mechasB/PID_Controller_Project/simulation/Identyfikacja/identyfikacja_cftool.png

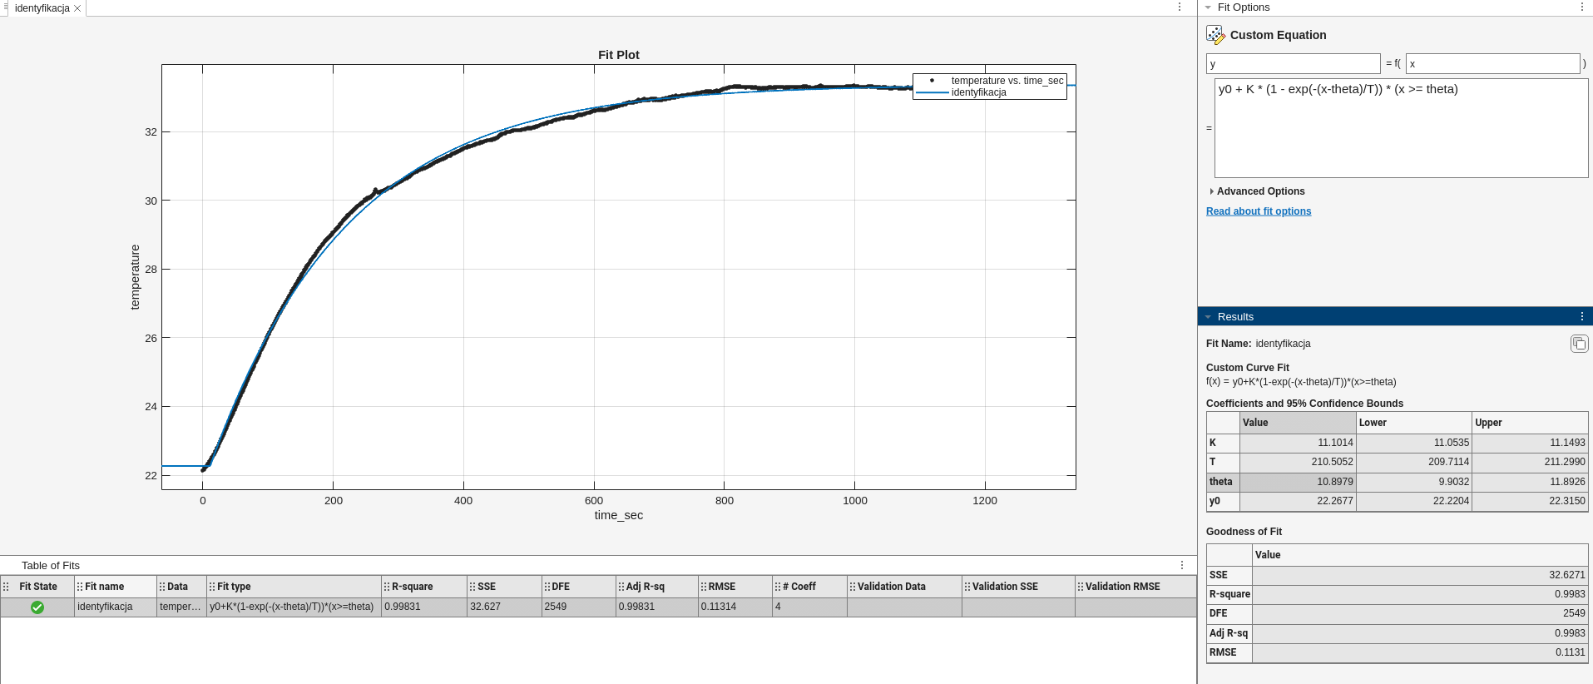
simulation/Identyfikacja/identyfikacja_cftool.png
