mechasB/PID_Controller_Project/hardware/PID_Controller_Project/PID_Controller_Project.kicad_sch

## KiCad design hardware/PID_Controller_Project/PID_Controller_Project.kicad_sch (2025-12-23, an earlier design)

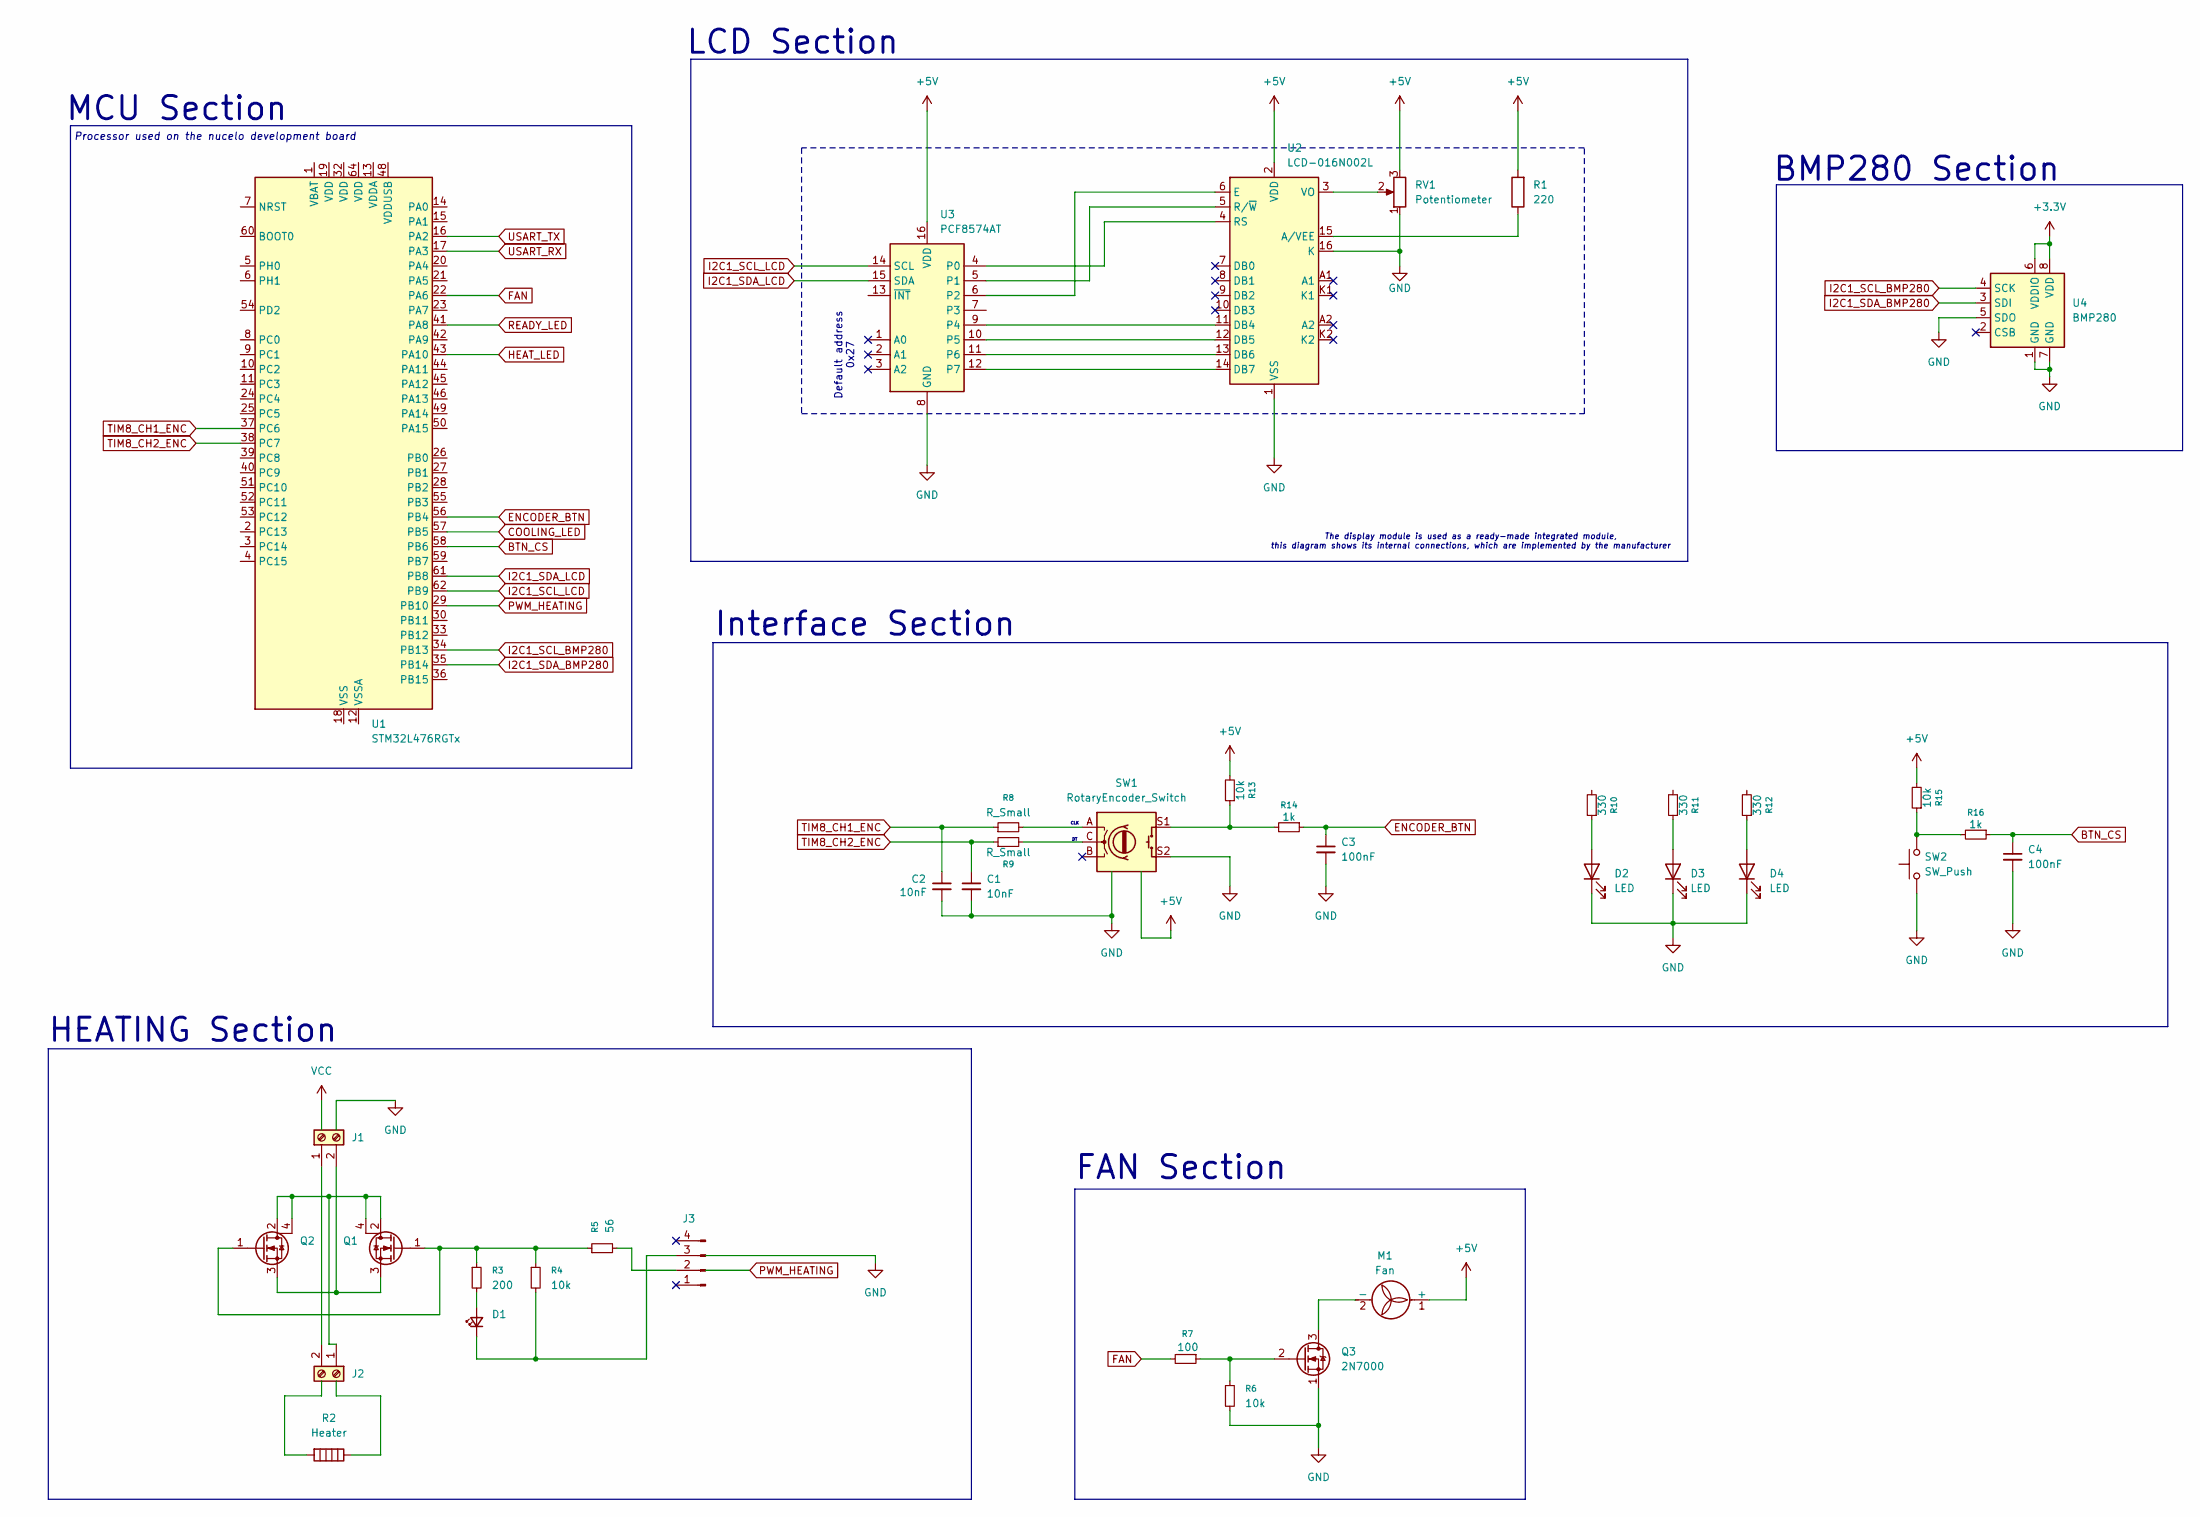
[picture p10: schematic PID_Controller_Project.kicad_sch]

Parts:
C1, C2: 10nF
C3, C4: 100nF
D1: LED_Small
D2, D3, D4: LED
J1, J2: Screw_Terminal_01x02
J3: Conn_01x04_Pin
M1: Fan
Q1, Q2: Q_NMOS_GDSD
Q3: 2N7000; TO-92_Inline
R1: 220
R2: Heater
R3: 200
R4, R6, R13, R15: 10k
R5: 56
R7: 100
R8, R9: R_Small
R10, R11, R12: 330
R14, R16: 1k
RV1: Potentiometer
SW1: RotaryEncoder_Switch
SW2: SW_Push
U1: STM32L476RGTx; LQFP-64_10x10mm_P0.5mm
U2: LCD-016N002L
U3: PCF8574AT; SOIC-16W_7.5x10.3mm_P1.27mm
U4: BMP280; Bosch_LGA-8_2x2.5mm_P0.65mm_ClockwisePinNumbering

Connections:
+3.3V: U4.6 (VDDIO), U4.8 (VDD)
+5V: M1.1 (+), R1.2, R13.2, R15.2, RV1.3, U2.2 (VDD), U3.16 (VDD)
BTN_CS: C4.1, R16.1, U1.58 (PB6)
COOLING_LED: U1.57 (PB5)
ENCODER_BTN: C3.1, R14.1, U1.56 (PB4)
FAN: R7.2, U1.22 (PA6)
GND: C1.2, C2.2, C3.2, C4.2, D2.1 (K), D3.1 (K), D4.1 (K), Q3.1 (S), R6.2, RV1.1, SW1.S2, SW2.1, U2.1 (VSS), U2.16 (K), U3.8 (GND), U4.1 (GND), U4.5 (SDO), U4.7 (GND)
HEAT_LED: U1.43 (PA10)
I2C1_SCL_BMP280: U1.34 (PB13), U4.4 (SCK)
I2C1_SCL_LCD: U1.62 (PB9), U3.14 (SCL)
I2C1_SDA_BMP280: U1.35 (PB14), U4.3 (SDI)
I2C1_SDA_LCD: U1.61 (PB8), U3.15 (SDA)
unnamed: D1.1 (K), J3.3, R4.2
unnamed: D1.2 (A), R3.2
unnamed: D2.2 (A), R10.1
unnamed: D3.2 (A), R11.1
unnamed: D4.2 (A), R12.1
unnamed: J1.1, J2.2
unnamed: J1.2, Q1.3 (S), Q2.3 (S)
unnamed: J2.1, Q1.2 (D), Q1.4 (D), Q2.2 (D), Q2.4 (D)
unnamed: J3.2, R5.2
unnamed: M1.2 (-), Q3.3 (D)
unnamed: Q1.1 (G), Q2.1 (G), R3.1, R4.1, R5.1
unnamed: Q3.2 (G), R6.1, R7.1
unnamed: R1.1, U2.15 (A/VEE)
unnamed: R8.2, SW1.A
unnamed: R9.2, SW1.C
unnamed: R13.1, R14.2, SW1.S1
unnamed: R15.1, R16.2, SW2.2
unnamed: RV1.2, U2.3 (VO)
unnamed: U1.18 (VSS), U1.31 (VSS), U1.47 (VSS), U1.63 (VSS)
unnamed: U2.4 (RS), U3.4 (P0)
unnamed: U2.5 (R/~W), U3.5 (P1)
unnamed: U2.6 (E), U3.6 (P2)
unnamed: U2.11 (DB4), U3.9 (P4)
unnamed: U2.12 (DB5), U3.10 (P5)
unnamed: U2.13 (DB6), U3.11 (P6)
unnamed: U2.14 (DB7), U3.12 (P7)
PWM_HEATING: U1.29 (PB10)
READY_LED: U1.41 (PA8)
TIM8_CH1_ENC: C2.1, R8.1, U1.37 (PC6)
TIM8_CH2_ENC: C1.1, R9.1, U1.38 (PC7)
USART_RX: U1.17 (PA3)
USART_TX: U1.16 (PA2)

Notes on the sheet:
Default address 0x27
BMP280 Section
Interface Section
Processor used on the nucelo development board
HEATING Section
LCD Section
MCU Section
FAN Section
CLK
The display module is used as a ready-made integrated module, this diagram shows its internal connections, which are implemented by the manufacturer
