mechasB/PID_Controller_Project/software/Firmware/Firmware.ioc

Mcu.UserName=STM32L476RGTx
PA10.GPIO_Label=HEAT_LED
PA10.Signal=GPIO_Output
PA2.GPIO_Label=USART_TX
PA2.Signal=USART2_TX
PA3.GPIO_Label=USART_RX
PA3.Signal=USART2_RX
PA5.GPIO_Label=LD2 [green Led]
PA5.Signal=GPIO_Output
PA6.GPIO_Label=FAN
PA6.Signal=GPIO_Output
PA7.Signal=GPIO_Output
PA8.GPIO_Label=READY_LED
PA8.Signal=GPIO_Output
PB10.Signal=S_TIM2_CH3
PB13.Signal=I2C2_SCL
PB14.Signal=I2C2_SDA
PB5.GPIO_Label=COOLING_LED
PB5.Signal=GPIO_Output
PB6.GPIO_Label=BTN_CS
PB6.Signal=GPIO_Input
PB8.Signal=I2C1_SCL
PB9.Signal=I2C1_SDA
PC13.GPIO_Label=B1 [Blue PushButton]
PC13.Signal=GPXTI13
PC6.Signal=S_TIM8_CH1
PC7.Signal=S_TIM8_CH2
