mechasB/PID_Controller_Project/software/Firmware/Core/Inc/main.h

#define B1_Pin GPIO_PIN_13
#define B1_GPIO_Port GPIOC
#define USART_TX_Pin GPIO_PIN_2
#define USART_TX_GPIO_Port GPIOA
#define USART_RX_Pin GPIO_PIN_3
#define USART_RX_GPIO_Port GPIOA
#define LD2_Pin GPIO_PIN_5
#define LD2_GPIO_Port GPIOA
#define FAN_Pin GPIO_PIN_6
#define FAN_GPIO_Port GPIOA
#define READY_LED_Pin GPIO_PIN_8
#define READY_LED_GPIO_Port GPIOA
#define HEAT_LED_Pin GPIO_PIN_10
#define HEAT_LED_GPIO_Port GPIOA
#define TMS_Pin GPIO_PIN_13
#define TMS_GPIO_Port GPIOA
#define TCK_Pin GPIO_PIN_14
#define TCK_GPIO_Port GPIOA
#define SWO_Pin GPIO_PIN_3
#define SWO_GPIO_Port GPIOB
#define ENCODER_BTN_Pin GPIO_PIN_4
#define ENCODER_BTN_GPIO_Port GPIOB
#define COOLING_LED_Pin GPIO_PIN_5
#define COOLING_LED_GPIO_Port GPIOB
#define BTN_CS_Pin GPIO_PIN_6
#define BTN_CS_GPIO_Port GPIOB
