mechasB/PID_Controller_Project/software/Firmware/Components/Encoder/encoder_config.h

#ifndef INC_ENCODER_CONFIG_H_
#define INC_ENCODER_CONFIG_H_

/* Config --------------------------------------------------------------------*/

/* Includes ------------------------------------------------------------------*/
#include "encoder.h"

/* Typedef -------------------------------------------------------------------*/

/* Define --------------------------------------------------------------------*/

/* Macro ---------------------------------------------------------------------*/

/* Public variables ----------------------------------------------------------*/
extern ENC_Handle_TypeDef henc1;

/* Public function prototypes ------------------------------------------------*/

#endif /* INC_ENCODER_CONFIG_H_ */
