mechasB/PID_Controller_Project/(commit log)

2025-10-24 Add ArduinoJson lib
2025-11-22 adc lcd lib, work on encoder
2025-11-22 Work on encoder counting
2025-11-23 Add encoder lib and refresh cmake
2025-11-23 encoder working
2025-11-23 add uart interface
2025-12-08 make schematic
    [PID_Controller_Project.kicad_pcb, PID_Controller_Project.kicad_sch]
2025-12-08 add display on lcd temperatures
2025-12-08 set temperatur by enocoder and display values on lcd
2025-12-08 add interrupt on timer and remove adc
2025-12-15 identification for increased supply voltage
    [pomiary_temperatury.csv]
2025-12-15 correct schema
    [PID_Controller_Project.kicad_sch]
2025-12-22 upgrade app and pid task - add fan info
2025-12-23 work at pid controller and user interface
2025-12-23 update schema
    [PID_Controller_Project.kicad_sch]
2025-12-23 Add README for Temperature Control System project
    Added detailed project overview, system architecture, control theory aspects, and getting started instructions for the temperature control system.
